mohammedbala/chipwheel/results/live-design-preview.png

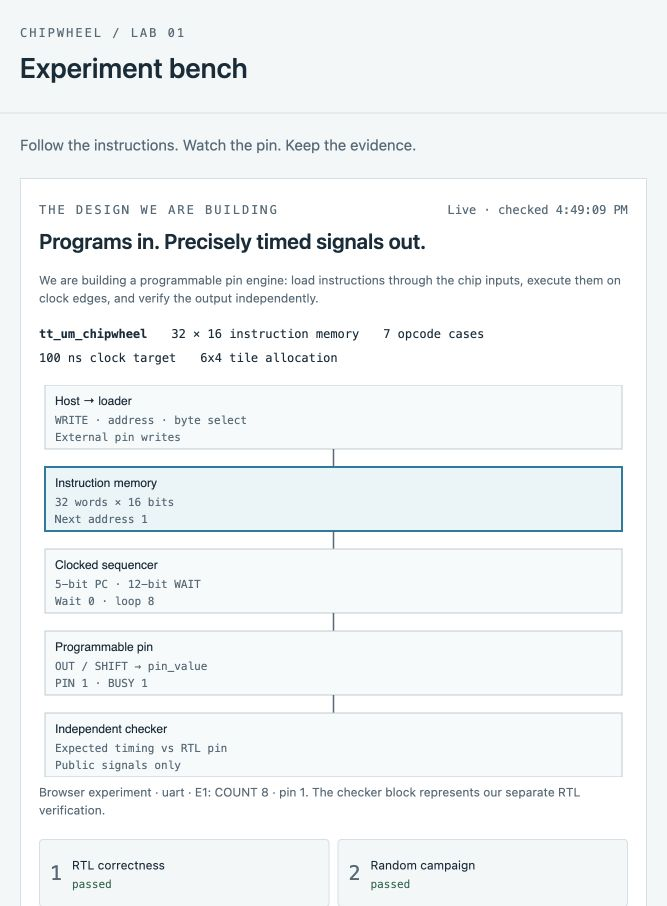
results/live-design-preview.png
