mohammedbala/chipwheel/results/campaign-audit-preview.png

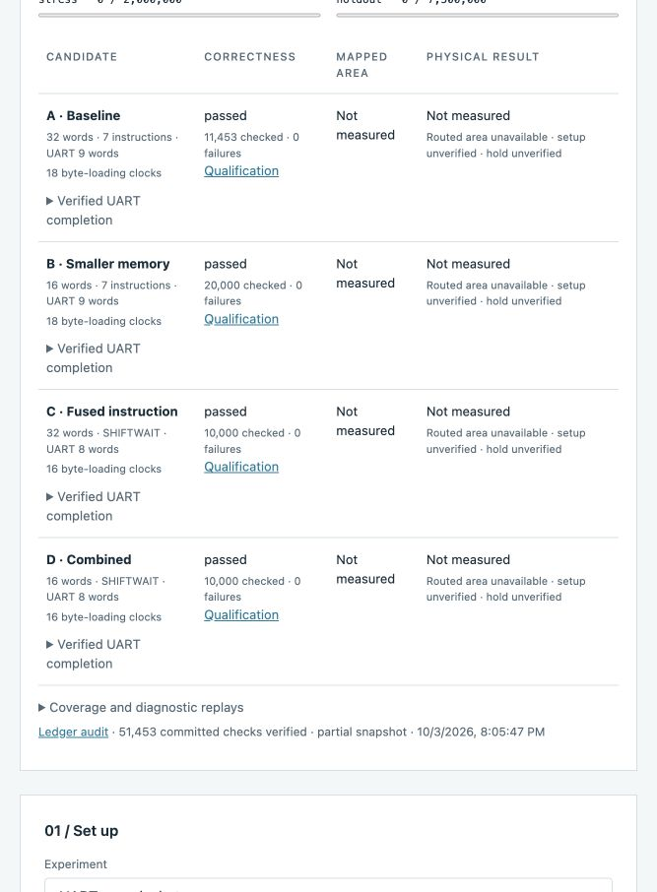
results/campaign-audit-preview.png
