mohammedbala/chipwheel/results/campaign-preview.png

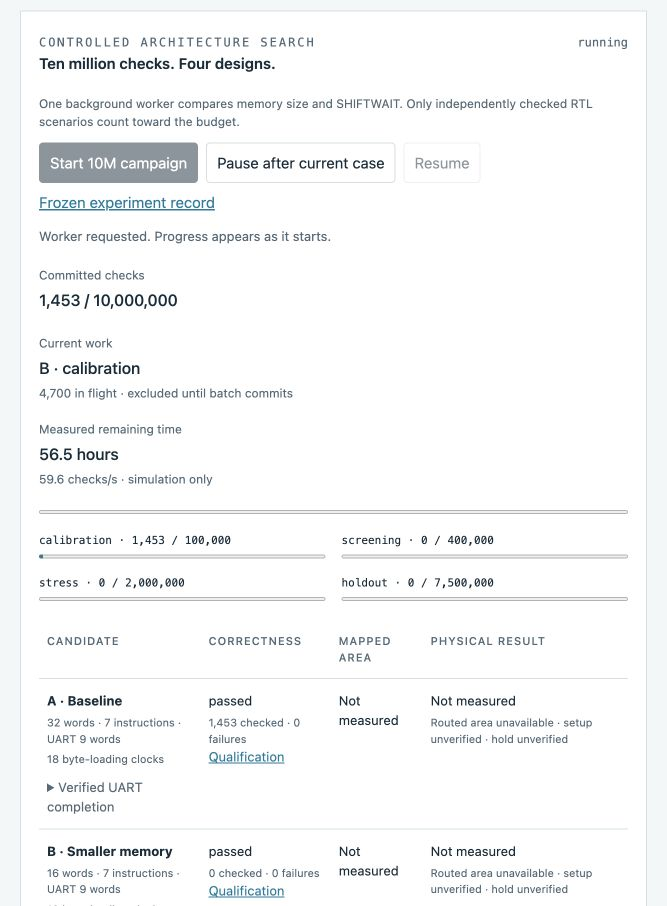
results/campaign-preview.png
