mohammedbala/chipwheel/results/simulator-preview.png

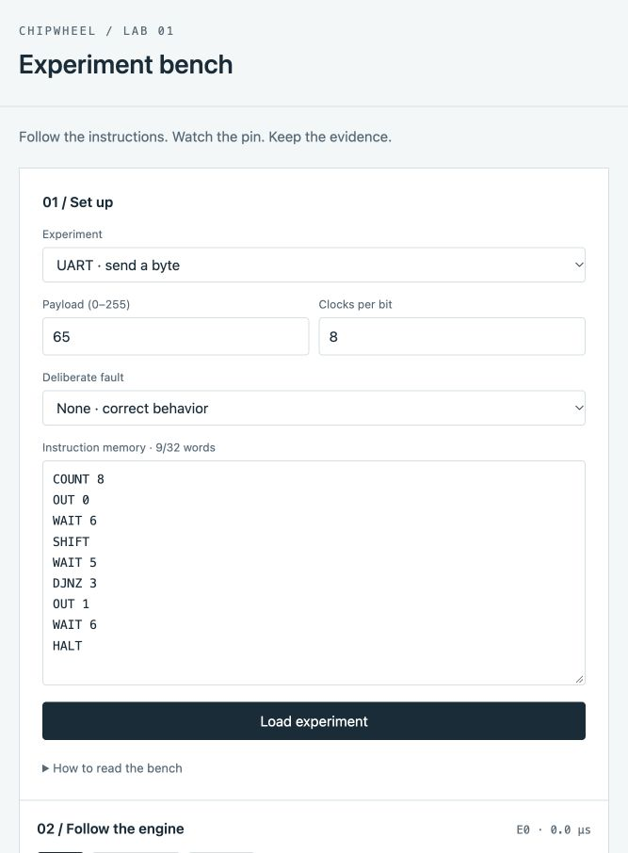
results/simulator-preview.png
