mohammedbala/chipwheel/(commit log)

2026-10-04 Chipwheel v2: compact protocol engine becomes the Tiny Tapeout entry
    Replace the v1 single-pin engine with Chipwheel v2 (src/project.v, top
    tt_um_chipwheel, 50 MHz, 1x1 tile): 10 eight-bit instructions plus 3 config
    bytes in a clock-gated latch array driving four bidirectional pins. UART
    TX/RX, SPI modes 0-3 (full duplex at SCK = clk/2), I2C master with clock
    stretching, and timed pulses. 13,829 um2 of cells.
    - docs/spec.md, docs/info.md, info.yaml describe v2; v1 archived in v1/.
    - test/test.py replays UART, SPI and I2C scenarios against the v2
    reference model (v2/model); test/cells_sim.v models the instantiated cells.
    - v2/: reference model, pin-level bench, replay/fuzz/mutation suites,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
    [demo-A.csv]
2026-10-04 Fix fast-corner gating hold: delay cell in each memory clock gate
    The first CI hardening run routed cleanly (setup slack 8.88 ns at 20 ns in
    the slow corner) but failed on 13 fast-corner hold violations, all the
    clock-gating check from each word's transparent-low enable latch to its AND
    gate (worst -31 ps): clock skew between latch and gate exceeded the latch
    delay. Insert sg13cmos5l_dlygate4sd3_1 (~240 ps at the fast corner) between
    latch and gate. RTL, gate-level and cocotb suites re-pass; 14,041 um2.
    [cells_sim.v, project.v]
2026-10-04 Chipwheel v3 (in development): general protocol engine
    Two state machines executing RP2040-PIO-encoded programs (16-bit data
    registers) plus per-bit hardware: a line unit per state machine (serializer/
    deserializer with its own bit timer, bit stuffing/destuffing, NRZI and
    Manchester encoding, edge-timing Manchester decode, timing recovery), a
    programmable 16-bit CRC, edge-clocked stepping, WAIT on edges with
    timeouts, differential output, and a 4-bit host bus that frees all eight
    uio pins for protocols. Instruction prefetch keeps the memory read and
    execute logic on separate timing paths.
    - v3/docs/spec.md, v3/model (assembler, reference model, bench, devices)
    - v3/src/chipwheel3.v (RTL), v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
2026-10-04 v3 branch: make Chipwheel v3 the Tiny Tapeout entry for CI hardening
    src/project.v is v3 (top tt_um_chipwheel), 4x2 tiles at 50 MHz, host nibble
    bus on ui/uo and eight protocol pins on uio. test/test.py replays UART, SPI,
    USB-style, Manchester and I2C scenarios built on the v3 reference model with
    independent devices (passes locally on RTL: 5/5).
2026-10-04 v3: translation features (SM-to-SM links, DDR input sampling, IN TIME)
    - Links (G1 LINK01/LINK10): an RX entry moves straight into the other SM's
    empty TX buffer, so one SM terminates protocol A and the other speaks
    protocol B with no host in the data path.
    - IN_DDR (CLKCTRL[7]): falling-edge input flops; IN PINS takes two samples
    per pin per clock, earlier sample first.
    - IN TIME (IN source 5): free-running 16-bit clock counter for edge
    timestamps.
    - Bench/replay drive a separate uio value for the falling-edge half clock.
    - 22 protocol tests (RTL and Yosys gate level), 25/25 mutants, 5.75M-cycle
    fuzz. Area 119,507 um2 (+3.7%), 13.1 ns slow-corner pre-layout.
    - docs/fast-protocols.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
2026-10-04 v3 branch: entry with links, DDR sampling and IN TIME
    Regenerates src/project.v and test/test.py from v3/ (7 cocotb scenarios,
    including USB-line-to-UART translation and DDR capture on the gate-level
    netlist); datasheet and description mention the translation features.
2026-10-04 v3 branch CI: time-limit the GDS build and keep partial flow logs
    The 4x2 v3 flow ran for over two hours without finishing, and the action
    publishes logs only when it ends. Stop it after 70 minutes and upload the
    per-step logs regardless.
